Gripsou/lethal-toothpaste/README.md

README
======

BRIEF
-----

This is the repository for STM32 sockets.

NOTE :
------

This text is in _Work in Progress_ state.
