Gripsou/lethal-toothpaste/Socket_STM32F446RxTy/TSX-3225_16.0000MF18X-AC0.step

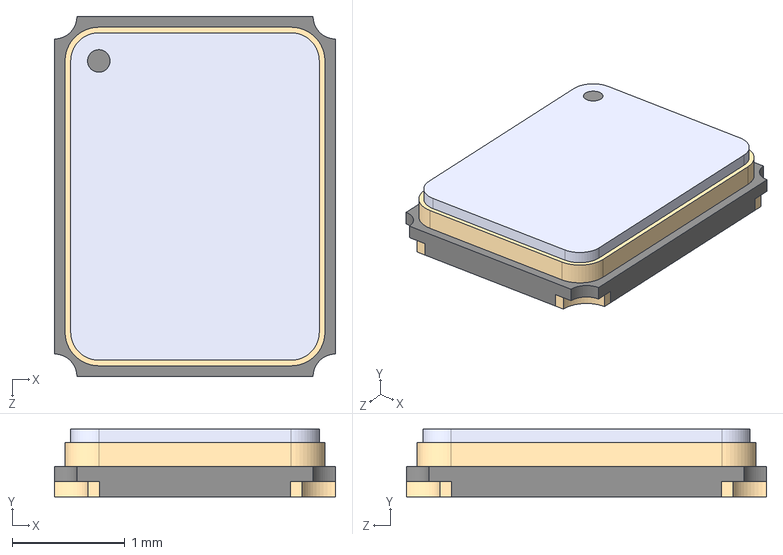
[picture p1: CAD file, 2025-01-16]
Socket_STM32F446RxTy/TSX-3225_16.0000MF18X-AC0.step
2.50 x 0.6 x 3.20 mm
