Gripsou/lethal-toothpaste/Socket_STM32F446RxTy/L_0805_2012Metric.step

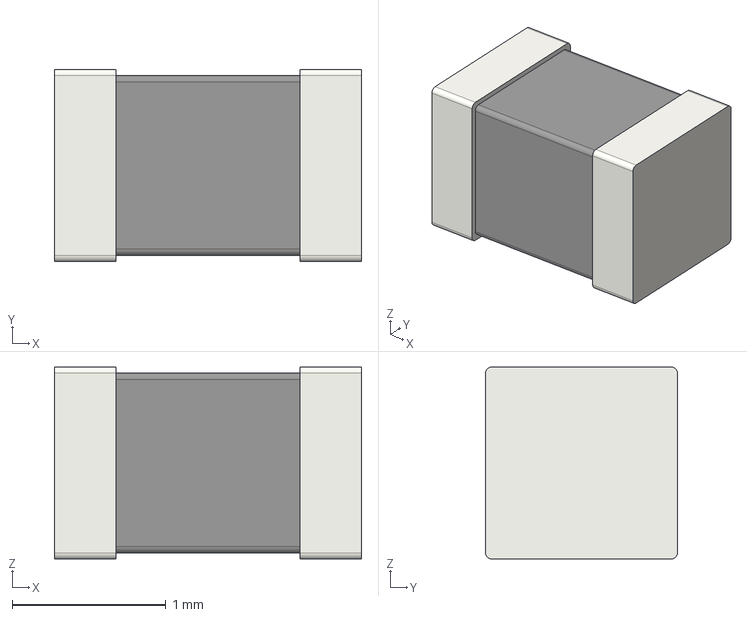
[picture p2: CAD file, 2025-01-16]
Socket_STM32F446RxTy/L_0805_2012Metric.step
2.00 x 1.25 x 1.25 mm
