Gripsou/lethal-toothpaste/Socket_STM32F446RxTy/Socket_STM32_V3.kicad_pcb

## KiCad design Socket_STM32F446RxTy/Socket_STM32_V3.kicad_pcb (2025-01-16)

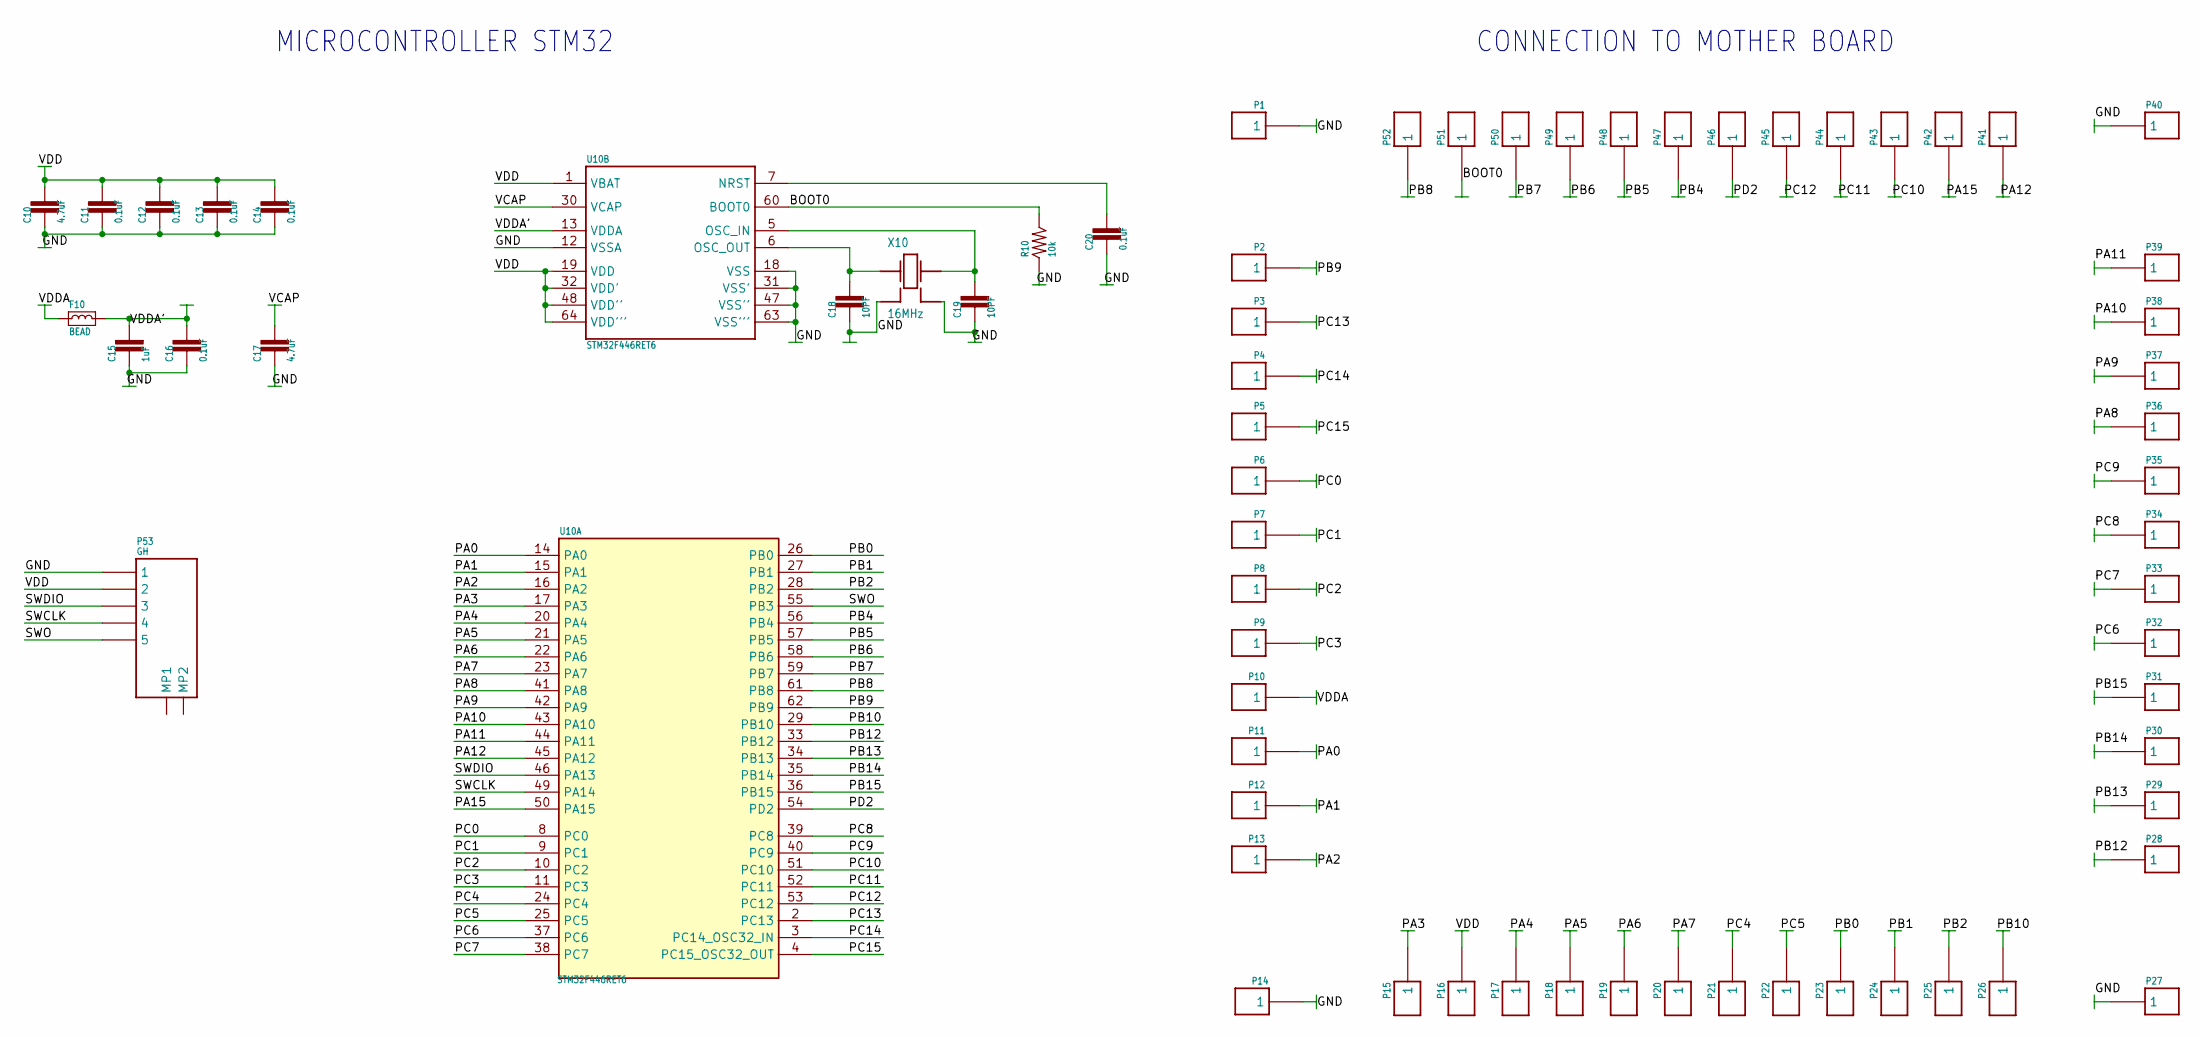
[picture p3: schematic Socket_STM32_V3.kicad_sch]

Parts:
C10, C17: 4.7uF; 0805_GRM
C11, C12, C13, C14, C16, C20: 0.1uF; 0805_GRM
C15: 1uF; 0805_GRM
C18, C19: 10PF; 0805_GRM
F10: BEAD; FERRITE_0805
P1, P14, P27, P40: PAD_CASTELLATED_HOLE_CORNER
P2, P3, P4, P5, P6, P7, P8, P9, P10, P11, P12, P13, P15, P16, P17, P18, P19, P20, P21, P22, P23, P24, P25, P26, P28, P29, P30, P31, P32, P33, P34, P35, P36, P37, P38, P39, P41, P42, P43, P44, P45, P46, P47, P48, P49, P50, P51, P52: PAD_1_1.51.2; PAD_1_1.5_1.2
P53: GH; JST_GH_5F
R10: 10k; RES_0805_ERJ
U10: STM32F446RET6; LQFP_64
X10: 16MHz; QUARTZ_TSX_3225

Connections:
BOOT0: P51.1, P51.2, P51.3, R10.2, U10.60 (BOOT0)
GND: C10.2 (1), C11.2 (1), C12.2 (1), C13.2 (1), C14.2 (1), C15.2 (1), C16.2 (1), C17.2 (1), C18.1, C19.1, C20.2 (1), P1.1, P14.1, P27.1, P40.1, P53.1, R10.1, U10.12 (VSSA), U10.18 (VSS), U10.31 (VSS'), U10.47 (VSS''), U10.63 (VSS'''), X10.2 (4), X10.4 (3)
unnamed: C18.2, U10.6 (OSC_OUT), X10.1
unnamed: C19.2, U10.5 (OSC_IN), X10.3 (2)
NRST: C20.1 (2), U10.7 (NRST)
PA0: P11.1, P11.2, P11.3, U10.14 (PA0)
PA1: P12.1, P12.2, P12.3, U10.15 (PA1)
PA2: P13.1, P13.2, P13.3, U10.16 (PA2)
PA3: P15.1, P15.2, P15.3, U10.17 (PA3)
PA4: P17.1, P17.2, P17.3, U10.20 (PA4)
PA5: P18.1, P18.2, P18.3, U10.21 (PA5)
PA6: P19.1, P19.2, P19.3, U10.22 (PA6)
PA7: P20.1, P20.2, P20.3, U10.23 (PA7)
PA8: P36.1, P36.2, P36.3, U10.41 (PA8)
PA9: P37.1, P37.2, P37.3, U10.42 (PA9)
PA10: P38.1, P38.2, P38.3, U10.43 (PA10)
PA11: P39.1, P39.2, P39.3, U10.44 (PA11)
PA12: P41.1, P41.2, P41.3, U10.45 (PA12)
PA15: P42.1, P42.2, P42.3, U10.50 (PA15)
PB0: P23.1, P23.2, P23.3, U10.26 (PB0)
PB1: P24.1, P24.2, P24.3, U10.27 (PB1)
PB2: P25.1, P25.2, P25.3, U10.28 (PB2)
PB4: P47.1, P47.2, P47.3, U10.56 (PB4)
PB5: P48.1, P48.2, P48.3, U10.57 (PB5)
PB6: P49.1, P49.2, P49.3, U10.58 (PB6)
PB7: P50.1, P50.2, P50.3, U10.59 (PB7)
PB8: P52.1, P52.2, P52.3, U10.61 (PB8)
PB9: P2.1, P2.2, P2.3, U10.62 (PB9)
PB10: P26.1, P26.2, P26.3, U10.29 (PB10)
PB12: P28.1, P28.2, P28.3, U10.33 (PB12)
PB13: P29.1, P29.2, P29.3, U10.34 (PB13)
PB14: P30.1, P30.2, P30.3, U10.35 (PB14)
PB15: P31.1, P31.2, P31.3, U10.36 (PB15)
PC0: P6.1, P6.2, P6.3, U10.8 (PC0)
PC1: P7.1, P7.2, P7.3, U10.9 (PC1)
PC2: P8.1, P8.2, P8.3, U10.10 (PC2)
PC3: P9.1, P9.2, P9.3, U10.11 (PC3)
PC4: P21.1, P21.2, P21.3, U10.24 (PC4)
PC5: P22.1, P22.2, P22.3, U10.25 (PC5)
PC6: P32.1, P32.2, P32.3, U10.37 (PC6)
PC7: P33.1, P33.2, P33.3, U10.38 (PC7)
PC8: P34.1, P34.2, P34.3, U10.39 (PC8)
PC9: P35.1, P35.2, P35.3, U10.40 (PC9)
PC10: P43.1, P43.2, P43.3, U10.51 (PC10)
PC11: P44.1, P44.2, P44.3, U10.52 (PC11)
PC12: P45.1, P45.2, P45.3, U10.53 (PC12)
PC13: P3.1, P3.2, P3.3, U10.2 (PC13)
PC14: P4.1, P4.2, P4.3, U10.3 (PC14_OSC32_IN)
PC15: P5.1, P5.2, P5.3, U10.4 (PC15_OSC32_OUT)
PD2: P46.1, P46.2, P46.3, U10.54 (PD2)
SWCLK: P53.4, U10.49 (PA14)
SWDIO: P53.3, U10.46 (PA13)
SWO: P53.5, U10.55 (PB3)
VCAP: C17.1 (2), U10.30 (VCAP)
VDD: C10.1 (2), C11.1 (2), C12.1 (2), C13.1 (2), C14.1 (2), P16.1, P16.2, P16.3, P53.2, U10.1 (VBAT), U10.19 (VDD), U10.32 (VDD'), U10.48 (VDD''), U10.64 (VDD''')
VDDA: F10.1, P10.1, P10.2, P10.3
VDDA': C15.1 (2), C16.1 (2), F10.2, U10.13 (VDDA)

Notes on the sheet:
CONNECTION TO MOTHER BOARD
MICROCONTROLLER STM32

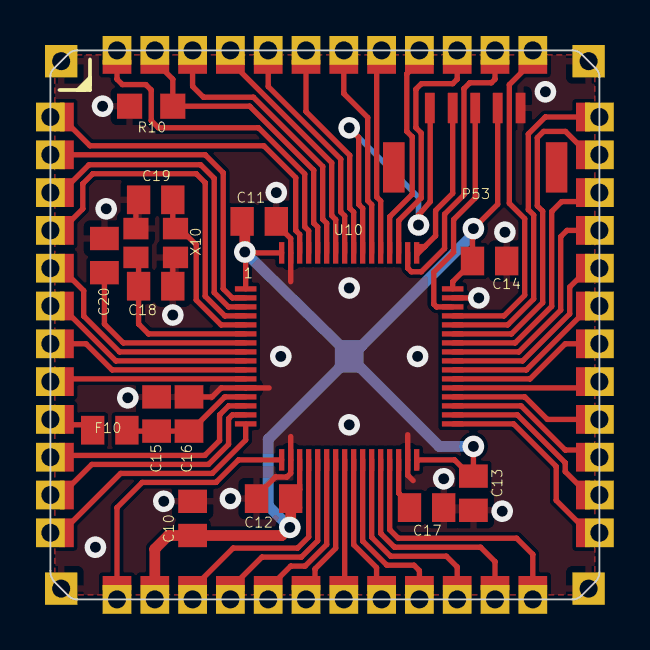
[picture p4: board Socket_STM32_V3.kicad_pcb from above]

Board: 2 copper layers, 30.5 x 30.5 mm, 68 parts (0 on the bottom side), 57 nets.
