Gripsou/lethal-toothpaste/(commit log)

2025-01-16 Import STM32F446RxTy EAGLE project
    Import EAGLE project for STM32F446RxTy microcontroller. It will be valid for STM32F446RET6, STM32F446RET7 and STM32F446RCT6, STM32F446RCT7.
    [Socket_STM32_V3.kicad_pcb, Socket_STM32_V3.kicad_sch]
2025-01-16 Update 3D models
    Update 3D models for footprint in local library. 3D model used are KiCad 8 standard library ones.
    NOTES :
    - Ferrite 3D model has to be updated since we use the 0805 resistor at the moment.
    - Update Crystal 3D model. This one is not updated in design so far.
    [Socket_STM32_V3.kicad_pcb]
2025-01-16 Update STM32F446 symbol
    * Create 0,25mm gird and set project on this new one
    * Update STM32F446RET6 symbol in local library.
    * Update schematic from local library
    * Remove empty sheet background.
    [Socket_STM32_V3.kicad_sch]
2025-01-16 Update Ferrite 3D model
    * Import Ferrite 3D model to repository : package is 0805.
    * Update component in local component footprint library (".kicad_mod" file).
    * Perform componen update from library in PCB layout.
    [L_0805_2012Metric.step, Socket_STM32_V3.kicad_pcb]
2025-01-16 Update quartz footprint & 3D model
    * Add 3D model to footprint
    * Update silkscreen size
    [TSX-3225_16.0000MF18X-AC0.step]
2025-01-16 Update footprints
    Update silkscreen size so they are fraction of metric dimensions
2025-01-16 Update PCB layout
    Update PCB layout (and 3D model) from updated footprint libraries.
    [Socket_STM32_V3.kicad_pcb]
2025-01-16 Update symbols & schematic
    * Improve symbols in library
    * Update all symbols in schematic from library
    [Socket_STM32_V3.kicad_sch]
