Gripsou/lethal-toothpaste/(notices)

Notices in the files:
Socket_STM32F446RxTy/L_0805_2012Metric.step:
Copyright (C) 2017, kicad StepUp
This work is licensed under the [Creative Commons CC-BY-SA 4.0 License](https://creativecommons.org/licenses/by-sa/4.0/legalcode),
with the following exception:
To the extent that the creation of electronic designs that use 'Licensed Material' can be considered to be 'Adapted Material',
You are free to use the library data in your own projects without the obligation to share your project files under this or any other license agreement.
